NilsAlexanderMueller/Arduino-based-central-heating-stove-extension/StoveExtension_control/StoveExtension_control.ino

/*
  StoveExtension_control

  Reads Temperature measurements, controls valves and circulating pumps to integrate a stove into a central heating system to heat raw water or/and heaters. 
  
  Temperature Measurements:
  - Smoke gas PT1000 (4-wire)
  - Raw water PT1000 (2-wire)
  - Forward flow central heating PT1000 (2-wire)

  Valves
  - Stove heat to Raw water
  - Stove heat to Forward flow central heating

  Circulating pumps
  - Stove heat exchanger flow
  - Forward flow central heating

  modified 17 December 2022
  by Nils A. Mueller

  https://github.com/NilsAlexanderMueller/Arduino-based-central-heating-stove-extension/tree/main
*/
//-----------------------------------------------------------------------------------
//---------------------------------CONSTANTS-----------------------------------------
//-----------------------------------------------------------------------------------
const PROGMEM uint32_t PT1000R[] = {185.2, 189.52, 193.84, 198.15, 202.47, 206.77, 211.08, 215.38, 219.67, 223.97, 228.25, 232.54, 236.82, 241.1, 245.38, 249.65, 253.92, 258.19, 262.45, 266.71, 270.96, 275.22, 279.47, 283.71, 287.96, 292.2, 296.43, 300.67, 304.9, 309.13, 313.35, 317.57, 321.79, 326.01, 330.22, 334.43, 338.64, 342.84, 347.04, 351.24, 355.43, 359.63, 363.82, 368, 372.19, 376.37, 380.55, 384.72, 388.89, 393.06, 397.23, 401.4, 405.56, 409.72, 413.88, 418.03, 422.18, 426.33, 430.48, 434.62, 438.76, 442.9, 447.04, 451.17, 455.31, 459.44, 463.56, 467.69, 471.81, 475.93, 480.05, 484.16, 488.28, 492.39, 496.49, 500.6, 504.7, 508.81, 512.91, 517, 521.1, 525.19, 529.28, 533.37, 537.46, 541.54, 545.62, 549.7, 553.78, 557.86, 561.93, 566, 570.07, 574.14, 578.21, 582.27, 586.33, 590.39, 594.45, 598.5, 602.56, 606.61, 610.66, 614.71, 618.76, 622.8, 626.84, 630.88, 634.92, 638.96, 643, 647.03, 651.06, 655.09, 659.12, 663.15, 667.17, 671.2, 675.22, 679.24, 683.25, 687.27, 691.29, 695.3, 699.31, 703.32, 707.33, 711.34, 715.34, 719.34, 723.35, 727.35, 731.34, 735.34, 739.34, 743.33, 747.32, 751.31, 755.3, 759.29, 763.28, 767.26, 771.25, 775.23, 779.21, 783.19, 787.17, 791.14, 795.12, 799.09, 803.06, 807.03, 811, 814.97, 818.94, 822.9, 826.87, 830.83, 834.79, 838.75, 842.71, 846.66, 850.62, 854.57, 858.53, 862.48, 866.43, 870.38, 874.32, 878.27, 882.22, 886.16, 890.1, 894.04, 897.98, 901.92, 905.86, 909.8, 913.73, 917.67, 921.6, 925.53, 929.46, 933.39, 937.32, 941.24, 945.17, 94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
1.95, 3854.89, 3857.84, 3860.78, 3863.73, 3866.67, 3869.61, 3872.55, 3875.49, 3878.43, 3881.36, 3884.3, 3887.23, 3890.16, 3893.1, 3896.03, 3898.96, 3901.88, 3904.81, 3907.74, 3910.66, 3913.59, 3916.51, 3919.43, 3922.35, 3925.27, 3928.19, 3931.1};
const double R0 = 1500; //Resistance value used for voltage divider
const int RTu = 1309; //Smoke gas 80 °C
const int RTl = 1232; //Smoke gas 60 °C
const int RTBu = 1232; //60 °C //1309; //Raw water 80 °C (60)
const int RTBl = 1194; //50 °C //1271; //Raw water 70 °C
const int RTVu = 1308; //80 °C //1232; //Forward flow Central heating system 60 °C
const int period = 1000; // Step size in milliseconds
const int koffset = -201;
const int period2 = 30000; // Active time period in milliseconds

//Input pins ("i"nput "p"in Voltage"U" number"0-2") (Pins 19-26)
//|----[||||]---*---[||||]--*--->>  
//GND    R0  (A6,A4)  RT   (A2) Vcc
const int ipU0 = A6; //U_R (1) 
const int ipU1 = A4; //U_PT1000_1_1 //4-wire-Smoke gas
const int ipU2 = A2; //U_PT1000_1_2 //4-wire-Smoke gas
//|----[||||]---*---[||||]--->> //
//GND    R0 (A0)/(A1) RT     Vcc
const int ipU3 = A0; //U_PT1000_2 //2-wire-Raw water
const int ipU4 = A1; //U_PT1000_3 //2-wire-Forward flow

//Output pins ("o"utput "p"in "R"elay number"1..4") (Pins 0-1;5-15))
const int opR1 = 2; //Relay IN1 //V1    //low-Active relay  //Raw water
const int opR2 = 3; //Relay IN2 //V2    //low-Active relay  //Central heating system Forward flow
const int opR3 = 4; //Relay IN3 //V_on  //low-Active relay  //Energy for Valves
const int opR4 = 5; //Relay IN4 //P1    //low-Active relay  //Circulating pump Stove
const int opR5 = 6; //Relay IN5 //P2    //high-Active relay //Circulating pump Forward flow Heating circuit

//-----------------------------------------------------------------------------------
//---------------------------------VARIABLES-----------------------------------------
//-----------------------------------------------------------------------------------

//Input values ("I"nput "V"alue Voltage"U" Number"0-4")
double ivU0 = 0;
double ivU1 = 0;
double ivU2 = 0;
double ivU3 = 0;
double ivU4 = 0;

//Output values ("O"utput "V"alue "R"elay Number"1..4" "N"ew)
int ovR1 = 1; int ovR1n = 1;
int ovR2 = 1; int ovR2n = 1;
int ovR3 = 1; int ovR3n = 1;
int ovR4 = 1; int ovR4n = 1;
int ovR5 = 0; int ovR5n = 0;

//Calculation
double RT = 0; //PT1000 resistance Smoke gas
double RTB = 0; //PT1000 resistance Raw water
double RTV = 0; //PT1000 resistance Forward flow
unsigned long pMillis = 0;
int Temp = 0; //Temperature
int TempDif = 29000; //n-1 Temperature Difference
int x2 = 0; //n Temperature Difference
int mode = 0;
int is_active = 0;
unsigned long cMillis2 = 0;
unsigned long pMillis2 = 0;

//-----------------------------------------------------------------------------------
//---------------------------------SETUP---------------------------------------------
//-----------------------------------------------------------------------------------

void setup() {
  // Set Outputs as input and set default state
  pinMode(opR1, OUTPUT); digitalWrite(opR1, HIGH);
  pinMode(opR2, OUTPUT); digitalWrite(opR2, HIGH);
  pinMode(opR3, OUTPUT); digitalWrite(opR3, HIGH);
  pinMode(opR4, OUTPUT); digitalWrite(opR4, HIGH);
  pinMode(opR5, OUTPUT); digitalWrite(opR5, LOW);
  // Initialize Serial communication
  Serial.begin(9600);
  delay(1000);
}

//-----------------------------------------------------------------------------------
//---------------------------------MAIN----------------------------------------------
//-----------------------------------------------------------------------------------

void loop() {
  unsigned long cMillis = millis(); //Check period
  if (cMillis - pMillis >= period) {
    pMillis = cMillis;

    readInput(); //Read Input values
    calcR(); //Calulate Resistances RT, RTB, RTV / temperatures
    setMode(); //Control logic: Set operating mode depending on temperatures
    setOutput(mode); //Set Outputs depending on calculated mode
    setActuatorsPower(); //Set actuators power if V1 or V2 need to change status
    writeSerial(); //Send values to serial
    writeOutput(); //Write Output values
  }
}

//-----------------------------------------------------------------------------------
//---------------------------------FUNCTIONS-----------------------------------------
//-----------------------------------------------------------------------------------

//---------------------------------RtoT_PT1000---------------------------------------
double RtoT_PT1000(double R){ //Calculate temperature value from resistance value using look-up table within boundaries, using function out of bounds
  double a = 3.9083E-03;
  double b = -5.7750E-07;
  uint32_t Rtable = 0;
  double rTemp = 0;
  for (uint16_t k = 0; k < 1060; k++) {
    if (R > 3931){
      rTemp = (-1000*a+sqrt(1000000*a*a-4000*b*(1000-R)))/(2000*b);
      return rTemp;
    }
    Rtable = pgm_read_word_near(PT1000R + k);
    x2 = abs(Rtable - R);

    if (x2 > TempDif) {
      rTemp = k+koffset;
      TempDif = 29000;
      x2 = 0;
      return rTemp;
    } else {
      TempDif = x2;
    }
  }
  return 9999;
}

//---------------------------------readInput-----------------------------------------
void readInput(){ //Read voltages from ADC with 4-values-average 
  ivU0 = 0; ivU1 = 0; ivU2 = 0; ivU3 = 0; ivU4 = 0;
  for (int k=0;k<4;k++){ //oversampling
    ivU0 += analogRead(ipU0); //Voltage U0:U_R0 min Value: 0/Gnd max Value: 1023/Vcc
    ivU1 += analogRead(ipU1); //Voltage U1:U_RT1 min Value: 0/Gnd max Value: 1023/Vcc
    ivU2 += analogRead(ipU2); //Voltage U2:U_RT2 min Value: 0/Gnd max Value: 1023/Vcc
    ivU3 += analogRead(ipU3); //Voltage U3:U_RTB min Value: 0/Gnd max Value: 1023/Vcc
    ivU4 += analogRead(ipU4); //Voltage U4:U_RTV min Value: 0/Gnd max Value: 1023/Vcc
  }
  ivU0 = ivU0 / 4; ivU1 = ivU1 / 4; ivU2 = ivU2 / 4; ivU3 = ivU3 / 4; ivU4 = ivU4 / 4; //averaging
  return;
}

//---------------------------------calcR---------------------------------------------
void calcR(){ //Calculate Resistances from ADC voltage measurements
  RT = R0 * abs(ivU2 - ivU1) / ivU0; // Calc RT
  RTB = R0 * (1023/ivU3 - 1); // Calc RTB
  RTV = R0 * (1023/ivU4 - 1); // Calc RTV
  return;
}

//---------------------------------setMode-------------------------------------------
void setMode(){ //Control Logic: Set operating modes depending on temperatures / resistance values
  if ((RT > RTu) & (is_active == 0) & (mode != 2)) mode = 1; //Turn On (Raw water heating)
  if ((RT > RTu) & (is_active == 0) & (mode == 2) && (RTB < RTBl)) mode = 1; //Turn On (Raw water heating)
  if ((RT > RTu) & (RTB > RTBu) & (is_active == 0)) mode = 2; //Switch Raw water heizen -> Central heating system Forward flow heizen

  if ((RT < RTl)) mode = 0; //Turn Off
  
  if (RT < 1000 || RT > 6000 || RTB < 1000 || RTB > 3000 || RTV < 1000 || RTV > 3000) mode = 2; //ERROR Measurement implausible! (Safe Mode = Mode 2) (0...1715 °C)
  
  return;
}

//---------------------------------setOutputs----------------------------------------
void setOutput(int mode) { //Set new output values depending on selected operating mode
  switch (mode){ //Set outputs
    case 0: //Turn Off
      ovR1n = 1;
      ovR2n = 1;
      ovR4n = 1;
      ovR5n = 0;
      break;
    case 1: //Turn On Standard (Raw water an)
      ovR4n = 0; //P1
      ovR1n = 0; //V1
      ovR5n = 0; //P2
      break;
    case 2: //Switch Raw water -> Forward flow (Forward flow an)
      ovR4n = 0; //P1
      ovR1n = 1; //V1
      ovR2n = 0; //V2
      ovR5n = 1; //P2
      break;
  }
  return;
}

//---------------------------------setActuatorsPower---------------------------------
void setActuatorsPower(){ // Power actuators for 30 sec after setting outputs
  // Turn actuators on if output status changed compared to last iteration
  if (ovR1 != ovR1n || ovR2 != ovR2n){ //Set active (Actors 30 sec energy)
    is_active = 1;
    pMillis2 = millis();
    ovR3n = 0;   
  }

  // Turn actuators off if time period (30 sec) is over
  cMillis2 = millis(); //Check period
  if ((cMillis2 - pMillis2 >= period2) & is_active == 1) { //Set passive (Turn Off Actors after 30 sec)
    is_active = 0;
    ovR3n = 1;
  }
  return;
}

//---------------------------------writeOutput---------------------------------------
void writeOutput(){ //Write new output values to current output states and wirte output states to Digital Outputs
  ovR1 = ovR1n;
  ovR2 = ovR2n;
  ovR3 = ovR3n;
  ovR4 = ovR4n;
  ovR5 = ovR5n;
  digitalWrite(opR1, ovR1); //V1
  digitalWrite(opR2, ovR2); //V2
  digitalWrite(opR3, ovR3); //V_on
  digitalWrite(opR4, ovR4); //P1
  digitalWrite(opR5, ovR5); //P2
  return;
}

//---------------------------------writeSerial---------------------------------------
void writeSerial(){ //Send status report to serial
  Serial.print("Mode: "); Serial.print(mode);
  Serial.print(" | Smoke gas: "); Serial.print(RtoT_PT1000(RT)); Serial.print(" °C "); Serial.print(RT); Serial.print(" Ohm |");
  Serial.print(" Raw water: "); Serial.print(RtoT_PT1000(RTB)); Serial.print(" °C "); Serial.print(RTB); Serial.print(" Ohm |");
  Serial.print(" Forward flow: "); Serial.print(RtoT_PT1000(RTV)); Serial.print(" °C "); Serial.print(RTV); Serial.println(" Ohm");
  return;
}
